Byenio/formula-student-radio-system/software/statlink/figures/cpu_master.png

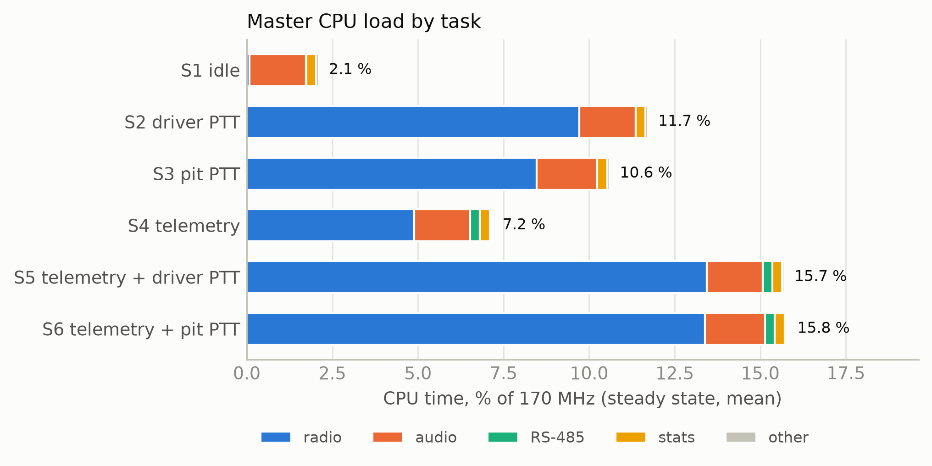
software/statlink/figures/cpu_master.png
