Byenio/formula-student-radio-system/software/statlink/figures/delivery.png

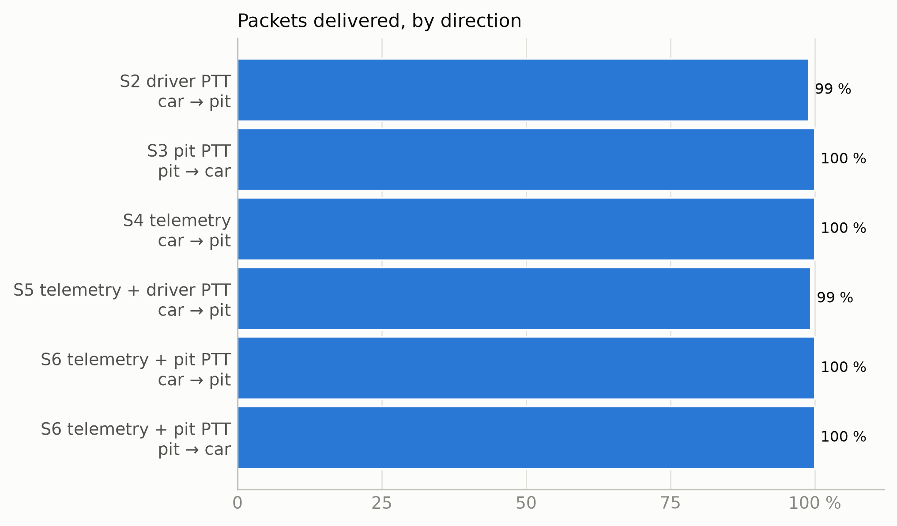
software/statlink/figures/delivery.png
