Byenio/formula-student-radio-system/software/statlink/figures/s6_timeline.png

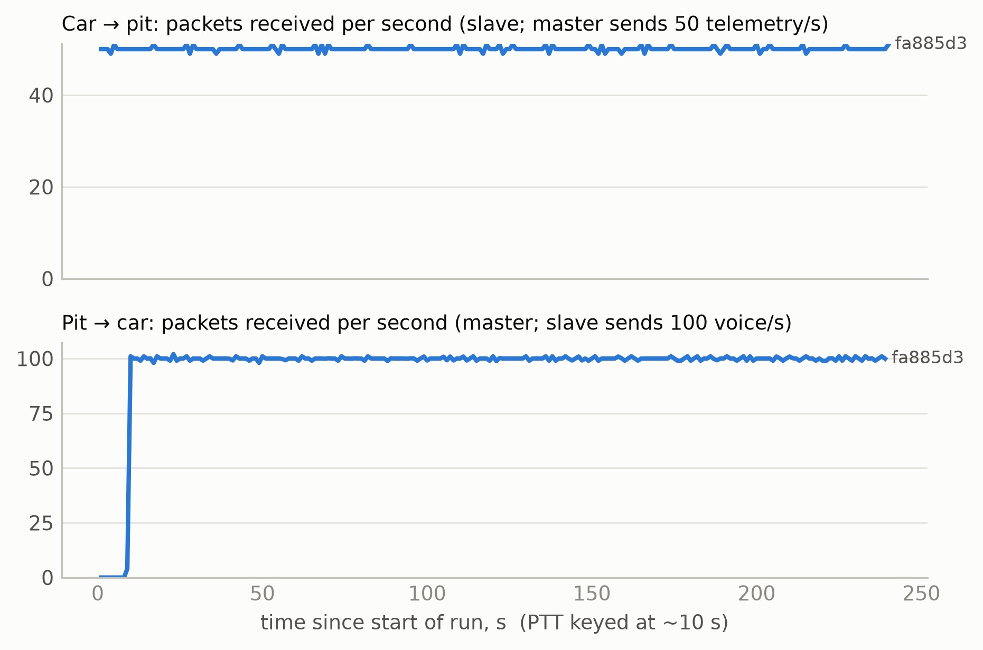
software/statlink/figures/s6_timeline.png
