Byenio/formula-student-radio-system/(list of files, drawings)

Other design files:
Radio_v2.PrjPcb
