Byenio/formula-student-radio-system/firmware/master/Core/Src/main.c

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
/* Includes ------------------------------------------------------------------*/
#include "main.h"
#include "cmsis_os.h"

/* USER CODE BEGIN Includes */
#include "audio.h"
#include "e28.h"
#include "ptt.h"
#include "rs485.h"
#include "can_bus.h"
#include "safety.h"
#include "stats.h"
/* USER CODE END Includes */

ADC_HandleTypeDef hadc1;
DMA_HandleTypeDef hdma_adc1;

DAC_HandleTypeDef hdac1;
DMA_HandleTypeDef hdma_dac1_ch1;

FDCAN_HandleTypeDef hfdcan1;

SPI_HandleTypeDef hspi2;

TIM_HandleTypeDef htim6;

UART_HandleTypeDef huart1;
DMA_HandleTypeDef hdma_usart1_rx;

/* Definitions for defaultTask */
osThreadId_t defaultTaskHandle;
const osThreadAttr_t defaultTask_attributes = {
  .name = "defaultTask",
  .priority = (osPriority_t) osPriorityNormal,
  .stack_size = 512 * 4
};
/* Definitions for myTask02 */
osThreadId_t myTask02Handle;
const osThreadAttr_t myTask02_attributes = {
  .name = "myTask02",
  .priority = (osPriority_t) osPriorityLow,
  .stack_size = 512 * 4
};
/* USER CODE BEGIN PV */
volatile uint32_t reset_csr      = 0;
volatile uint8_t  rst_pin        = 0;   /* NRST pin pulled low       */
volatile uint8_t  rst_brownout   = 0;   /* supply dipped below BOR   */
volatile uint8_t  rst_software   = 0;   /* NVIC_SystemReset() called */
volatile uint8_t  rst_iwdg       = 0;   /* independent watchdog      */
volatile uint8_t  rst_wwdg       = 0;   /* window watchdog           */
volatile uint8_t  rst_lowpower   = 0;   /* illegal low-power entry   */
/* USER CODE END PV */

void SystemClock_Config(void);
static void MX_GPIO_Init(void);
static void MX_DMA_Init(void);
static void MX_ADC1_Init(void);
static void MX_DAC1_Init(void);
static void MX_TIM6_Init(void);
static void MX_SPI2_Init(void);
static void MX_USART1_UART_Init(void);
static void MX_FDCAN1_Init(void);
void StartDefaultTask(void *argument);
void StartTask02(void *argument);

/**
  * @brief  The application entry point.
  * @retval int
  */
int main(void)
{

  /* USER CODE BEGIN 1 */
	/* Latch why we last reset, before anything clears the flags. */
	  reset_csr    = RCC->CSR;
	  rst_pin      = (reset_csr & RCC_CSR_PINRSTF)  ? 1U : 0U;
	  rst_brownout = (reset_csr & RCC_CSR_BORRSTF)  ? 1U : 0U;
	  rst_software = (reset_csr & RCC_CSR_SFTRSTF)  ? 1U : 0U;
	  rst_iwdg     = (reset_csr & RCC_CSR_IWDGRSTF) ? 1U : 0U;
	  rst_wwdg     = (reset_csr & RCC_CSR_WWDGRSTF) ? 1U : 0U;
	  rst_lowpower = (reset_csr & RCC_CSR_LPWRRSTF) ? 1U : 0U;
	  __HAL_RCC_CLEAR_RESET_FLAGS();
  /* USER CODE END 1 */

  /* MCU Configuration--------------------------------------------------------*/

  /* Reset of all peripherals, Initializes the Flash interface and the Systick. */
  HAL_Init();

  /* Configure the system clock */
  SystemClock_Config();

  /* Initialize all configured peripherals */
  MX_GPIO_Init();
  MX_DMA_Init();
  MX_ADC1_Init();
  MX_DAC1_Init();
  MX_TIM6_Init();
  MX_SPI2_Init();
  MX_USART1_UART_Init();
  MX_FDCAN1_Init();
  /* USER CODE BEGIN 2 */
  /* Audio peripherals are armed by the audio task itself, so the DMA
     streams start only once the scheduler is running. */
  /* USER CODE END 2 */

  /* Init scheduler */
  osKernelInitialize();

  /* USER CODE BEGIN RTOS_MUTEX */
  /* add mutexes, ... */
  /* USER CODE END RTOS_MUTEX */

  /* USER CODE BEGIN RTOS_SEMAPHORES */
  /* add semaphores, ... */
  /* USER CODE END RTOS_SEMAPHORES */

  /* USER CODE BEGIN RTOS_TIMERS */
  /* start timers, add new ones, ... */
  /* USER CODE END RTOS_TIMERS */

  /* USER CODE BEGIN RTOS_QUEUES */
  /* add queues, ... */
  /* USER CODE END RTOS_QUEUES */

  /* Create the thread(s) */
  /* creation of defaultTask */
  defaultTaskHandle = osThreadNew(StartDefaultTask, NULL, &defaultTask_attributes);

  /* creation of myTask02 */
  myTask02Handle = osThreadNew(StartTask02, NULL, &myTask02_attributes);

  /* USER CODE BEGIN RTOS_THREADS */
  /* First: starts the cycle counter every other module's timing relies on,
     and sends the boot-time schema before anything else can fail. */
  Stats_Init();
  Audio_Init();
  E28_Init();
  RS485_Init();
  CanBus_Init();
  /* USER CODE END RTOS_THREADS */

  /* USER CODE BEGIN RTOS_EVENTS */
  /* add events, ... */
  /* USER CODE END RTOS_EVENTS */

  /* Start scheduler */
  osKernelStart();

  /* We should never get here as control is now taken by the scheduler */

  /* Infinite loop */
  /* USER CODE BEGIN WHILE */
  while (1)
  {
    /* USER CODE END WHILE */

    /* USER CODE BEGIN 3 */
    /* Unreachable: osKernelStart() above never returns.
       All application logic now lives in the task functions. */
  }
  /* USER CODE END 3 */
}

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
/* USER CODE BEGIN Header_StartDefaultTask */
/**
  * @brief  Function implementing the defaultTask thread.
  * @param  argument: Not used
  * @retval None
  */
/* USER CODE END Header_StartDefaultTask */
void StartDefaultTask(void *argument)
{
  /* USER CODE BEGIN 5 */
	for(;;)
	  {
	    CanBus_Poll();
	    Ptt_SetCanAuthority(CanBus_IsLinkAlive());

	    /* LED1: solid = VCU is talking to us over CAN, off = bench mode and the
	       board button is in charge. More informative than a heartbeat, and it
	       makes a dead harness obvious at a glance. */
	    HAL_GPIO_WritePin(STATUS_LED1_GPIO_Port, STATUS_LED1_Pin,
	                      CanBus_IsLinkAlive() ? GPIO_PIN_SET : GPIO_PIN_RESET);
	    osDelay(20);
	  }
  /* USER CODE END 5 */
}

/* USER CODE BEGIN Header_StartTask02 */
/**
* @brief Function implementing the myTask02 thread.
* @param argument: Not used
* @retval None
*/
/* USER CODE END Header_StartTask02 */
void StartTask02(void *argument)
{
  /* USER CODE BEGIN StartTask02 */
	Ptt_Init();

	  for(;;)
	  {
	    Ptt_Poll();

	    /* LED2 now shows mic state rather than button state -- during the
	       hangover the radio is still transmitting, but the driver has already
	       let go, and the light should agree with the driver. */
	    HAL_GPIO_WritePin(STATUS_LED2_GPIO_Port, STATUS_LED2_Pin,
	                      Ptt_IsOpen() ? GPIO_PIN_SET : GPIO_PIN_RESET);
	    osDelay(20);
	  }
  /* USER CODE END StartTask02 */
}

/**
  * @brief  Period elapsed callback in non blocking mode
  * @note   This function is called  when TIM7 interrupt took place, inside
  * HAL_TIM_IRQHandler(). It makes a direct call to HAL_IncTick() to increment
  * a global variable "uwTick" used as application time base.
  * @param  htim : TIM handle
  * @retval None
  */
void HAL_TIM_PeriodElapsedCallback(TIM_HandleTypeDef *htim)
{
  if (htim->Instance == TIM7)
  {
    HAL_IncTick();
  }
}

/**
  * @brief  This function is executed in case of error occurrence.
  * @retval None
  */
void Error_Handler(void)
{
  /* USER CODE BEGIN Error_Handler_Debug */
  /* Called by CubeMX init code when a HAL call fails. Used to spin silently;
     now it shuts the radio down and latches the call site -- the return
     address of this function -- so addr2line can say which init failed. */
  Safety_ErrorHandler(__builtin_return_address(0));
  /* USER CODE END Error_Handler_Debug */
}
#ifdef USE_FULL_ASSERT
/**
  * @brief  Reports the name of the source file and the source line number
  *         where the assert_param error has occurred.
  * @param  file: pointer to the source file name
  * @param  line: assert_param error line source number
  * @retval None
  */
void assert_failed(uint8_t *file, uint32_t line)
{
  /* USER CODE BEGIN 6 */
  /* User can add his own implementation to report the file name and line number,
     ex: printf("Wrong parameters value: file %s on line %d\r\n", file, line) */
  /* USER CODE END 6 */
}
#endif /* USE_FULL_ASSERT */
