Byenio/formula-student-radio-system/firmware/master/master.ioc

Mcu.UserName=STM32G491CETx
PA10.Signal=USART1_RX
PA11.Signal=FDCAN1_RX
PA12.Signal=FDCAN1_TX
PA13.Signal=SYS_JTMS-SWDIO
PA14.Signal=SYS_JTCK-SWCLK
PA4.Signal=COMP_DAC11_group
PA5.GPIO_Label=E28_BUSY
PA5.Signal=GPIO_Input
PA6.GPIO_Label=CAN_STB
PA6.Signal=GPIO_Output
PA7.GPIO_Label=CAN_SHDN
PA7.Signal=GPIO_Output
PA8.GPIO_Label=STATUS_LED1
PA8.Signal=GPIO_Output
PA9.Signal=USART1_TX
PB0.Signal=ADC1_IN15
PB10.GPIO_Label=E28_RX_EN
PB10.Signal=GPIO_Output
PB11.GPIO_Label=E28_NRESET
PB11.Signal=GPIO_Output
PB12.GPIO_Label=E28_CS
PB12.Signal=GPIO_Output
PB13.Signal=SPI2_SCK
PB14.Signal=SPI2_MISO
PB15.Signal=SPI2_MOSI
PB4.GPIO_Label=E28_DIO3
PB4.Signal=GPIO_Input
PB5.GPIO_Label=E28_DIO1
PB5.Signal=GPXTI5
PB6.GPIO_Label=E28_DIO2
PB6.Signal=GPIO_Input
PB7.GPIO_Label=STATUS_LED2
PB7.Signal=GPIO_Output
PB9.GPIO_Label=E28_TX_EN
PB9.Signal=GPIO_Output
PC13.GPIO_Label=PTT_BTN
PC13.Signal=GPIO_Input
PC14-OSC32_IN.GPIO_Label=RS485_RE_DE
PC14-OSC32_IN.Signal=GPIO_Output
PF0-OSC_IN.Signal=RCC_OSC_IN
PF1-OSC_OUT.Signal=RCC_OSC_OUT
