Byenio/formula-student-radio-system/firmware/slave/Core/Src/main.c

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
/* Includes ------------------------------------------------------------------*/
#include "main.h"
#include "app_usbx_device.h"

/* USER CODE BEGIN Includes */
#include "e28_radio.h"
#include "usb_link.h"
#include "safety.h"
#include "stats.h"
#include "perf.h"
/* USER CODE END Includes */

ADC_HandleTypeDef hadc1;

I2C_HandleTypeDef hi2c1;

SPI_HandleTypeDef hspi1;

UART_HandleTypeDef huart1;

PCD_HandleTypeDef hpcd_USB_DRD_FS;

void SystemClock_Config(void);
static void MX_GPIO_Init(void);
static void MX_I2C1_Init(void);
static void MX_SPI1_Init(void);
static void MX_USART1_UART_Init(void);
static void MX_USB_PCD_Init(void);
static void MX_ADC1_Init(void);
static void MX_ICACHE_Init(void);
/**
  * @brief  The application entry point.
  * @retval int
  */
int main(void)
{

  /* MCU Configuration--------------------------------------------------------*/

  /* Reset of all peripherals, Initializes the Flash interface and the Systick. */
  HAL_Init();

  /* Configure the system clock */
  SystemClock_Config();

  /* Initialize all configured peripherals */
  MX_GPIO_Init();
  MX_I2C1_Init();
  MX_SPI1_Init();
  MX_USART1_UART_Init();
  MX_USB_PCD_Init();
  MX_ADC1_Init();
  MX_ICACHE_Init();
  MX_USBX_Device_Init();
  /* USER CODE BEGIN 2 */
  if (ux_dcd_stm32_initialize((ULONG)USB_DRD_FS,
                                (ULONG)&hpcd_USB_DRD_FS) != UX_SUCCESS)
	{
	  Error_Handler();
	}

	if (HAL_PCD_Start(&hpcd_USB_DRD_FS) != HAL_OK)
	{
	  Error_Handler();
	}

  UsbLink_Init();
  E28_Init();

  if (E28_GetTestResult() == E28_TEST_OK)
  {
    (void)E28_Radio_RelayInit();
  }

  /* Last, so the boot-time schema reflects a fully initialised board. */
  Stats_Init();
  /* USER CODE END 2 */

  /* Infinite loop */
  /* USER CODE BEGIN WHILE */
  while (1)
  {
    /* USER CODE END WHILE */

    /* USER CODE BEGIN 3 */
    /* Each stage timed separately, and the whole pass as "loop": on a
       bare-metal board the loop rate is the CPU budget, and these four
       sections show where it goes. Stats_Poll sits outside the loop timing
       so the report it sends is not counted inside the pass it measures. */
    {
      PERF_BEGIN(PERF_LOOP);
      {
        PERF_BEGIN(PERF_USBX);
        ux_system_tasks_run();
        PERF_END(PERF_USBX);
      }
      {
        PERF_BEGIN(PERF_USBLINK);
        UsbLink_Poll();
        PERF_END(PERF_USBLINK);
      }
      {
        PERF_BEGIN(PERF_RELAY);
        E28_Radio_RelayPoll();
        PERF_END(PERF_RELAY);
      }
      PERF_END(PERF_LOOP);
    }

    Stats_Poll();
  }
  /* USER CODE END 3 */
}

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
/**
  * @brief  Period elapsed callback in non blocking mode
  * @note   This function is called  when TIM6 interrupt took place, inside
  * HAL_TIM_IRQHandler(). It makes a direct call to HAL_IncTick() to increment
  * a global variable "uwTick" used as application time base.
  * @param  htim : TIM handle
  * @retval None
  */
void HAL_TIM_PeriodElapsedCallback(TIM_HandleTypeDef *htim)
{
  if (htim->Instance == TIM6)
  {
    HAL_IncTick();
  }
}

/**
  * @brief  This function is executed in case of error occurrence.
  * @retval None
  */
void Error_Handler(void)
{
  /* USER CODE BEGIN Error_Handler_Debug */
  /* Called by CubeMX init code when a HAL call fails. Used to spin silently;
     now it shuts the radio down and latches the call site -- the return
     address of this function -- so addr2line can say which init failed. */
  Safety_ErrorHandler(__builtin_return_address(0));
  /* USER CODE END Error_Handler_Debug */
}
#ifdef USE_FULL_ASSERT
/**
  * @brief  Reports the name of the source file and the source line number
  *         where the assert_param error has occurred.
  * @param  file: pointer to the source file name
  * @param  line: assert_param error line source number
  * @retval None
  */
void assert_failed(uint8_t *file, uint32_t line)
{
  /* USER CODE BEGIN 6 */
  /* User can add his own implementation to report the file name and line number,
     ex: printf("Wrong parameters value: file %s on line %d\r\n", file, line) */
  /* USER CODE END 6 */
}
#endif /* USE_FULL_ASSERT */
