Byenio/formula-student-radio-system/firmware/master/Core/Inc/main.h

#define PTT_BTN_Pin GPIO_PIN_13
#define PTT_BTN_GPIO_Port GPIOC
#define RS485_RE_DE_Pin GPIO_PIN_14
#define RS485_RE_DE_GPIO_Port GPIOC
#define E28_BUSY_Pin GPIO_PIN_5
#define E28_BUSY_GPIO_Port GPIOA
#define CAN_STB_Pin GPIO_PIN_6
#define CAN_STB_GPIO_Port GPIOA
#define CAN_SHDN_Pin GPIO_PIN_7
#define CAN_SHDN_GPIO_Port GPIOA
#define E28_RX_EN_Pin GPIO_PIN_10
#define E28_RX_EN_GPIO_Port GPIOB
#define E28_NRESET_Pin GPIO_PIN_11
#define E28_NRESET_GPIO_Port GPIOB
#define E28_CS_Pin GPIO_PIN_12
#define E28_CS_GPIO_Port GPIOB
#define STATUS_LED1_Pin GPIO_PIN_8
#define STATUS_LED1_GPIO_Port GPIOA
#define E28_DIO3_Pin GPIO_PIN_4
#define E28_DIO3_GPIO_Port GPIOB
#define E28_DIO1_Pin GPIO_PIN_5
#define E28_DIO1_GPIO_Port GPIOB
#define E28_DIO1_EXTI_IRQn EXTI9_5_IRQn
#define E28_DIO2_Pin GPIO_PIN_6
#define E28_DIO2_GPIO_Port GPIOB
#define STATUS_LED2_Pin GPIO_PIN_7
#define STATUS_LED2_GPIO_Port GPIOB
#define E28_TX_EN_Pin GPIO_PIN_9
#define E28_TX_EN_GPIO_Port GPIOB
#define STATUS_LED1_BLINK_PERIOD_MS 500U
#define E28_SPI_HANDLE hspi2
#define E28_ROLE_TRANSMITTER 1
#define AUDIO_PATH 0
#define RS485_BENCH_TEST 1
