Byenio/formula-student-radio-system/firmware/slave/Core/Src/stats.c

/**
  ******************************************************************************
  * @file    stats.c
  * @brief   Statistics layer. See stats.h for the frame formats.
  *
  * IDENTICAL ON BOTH BOARDS.
  *
  * Scheduling
  * ----------
  * Master: a dedicated task at osPriorityLow, woken every STATS_SAMPLE_MS by
  * vTaskDelayUntil. Low, so it never delays audio, radio, RS-485 or CAN; the
  * cost of that is that under heavy load a report can be late, which shows up
  * as jitter in t_ms rather than as corrupted data.
  *
  * Slave: Stats_Poll() from the bare-metal main loop, checking HAL_GetTick.
  *
  * Either way the work per report is the same and is timed by the stats.self
  * section, so the layer's own cost is part of every log.
  ******************************************************************************
  */

#include "stats.h"

#if FW_STATS_ENABLE

#include <string.h>
#include "statlink.h"

/* ==========================================================================
   Board configuration
   ========================================================================== */

#if defined(FW_HOST_TEST)
  #define STATS_BOARD_ID    255U
  #define STATS_HAS_RTOS    0
  extern uint32_t stats_host_ms;
  extern uint32_t stats_host_core_hz;
  #define STATS_NOW_MS()    (stats_host_ms)
  #define STATS_CORE_HZ()   (stats_host_core_hz)
#else
  #include "main.h"
  #define STATS_NOW_MS()    HAL_GetTick()
  #define STATS_CORE_HZ()   SystemCoreClock
  #if defined(STM32G491xx)
    #define STATS_BOARD_ID  0U
    #define STATS_HAS_RTOS  1
  #elif defined(STM32U375xx)
    #define STATS_BOARD_ID  1U
    #define STATS_HAS_RTOS  0
  #else
    #error "stats.c: unknown board -- add it to the board configuration block"
  #endif
#endif

#if STATS_HAS_RTOS
  #include "cmsis_os2.h"
  #include "FreeRTOS.h"
  #include "task.h"
#endif

/* Build identity, generated by cmake/build_info.cmake on every build. */
#if defined(FW_HOST_TEST)
  #define FW_BUILD_GIT      "host-test"
  #define FW_BUILD_TYPE     "host"
#else
  #include "build_info.h"
#endif

#define STATS_TASKS_EVERY   (STATS_TASKS_MS  / STATS_SAMPLE_MS)
#define STATS_SCHEMA_EVERY  (STATS_SCHEMA_MS / STATS_SAMPLE_MS)

/* Largest payload is the schema: ~20 B header, ~100 B build string, and up
   to 64 fields and 16 sections at ~20 B each. */
#define STATS_PAYLOAD_MAX   1600U

/* ==========================================================================
   State
   ========================================================================== */

static uint8_t       payload[STATS_PAYLOAD_MAX];
static uint32_t      frame_seq;
static uint16_t      schema_id;
static uint32_t      report_count;
static uint32_t      last_window_cycles;
static perf_window_t perf_snap[PERF_COUNT];
static uint32_t      field_values[STATS_MAX_FIELDS];

#if STATS_HAS_RTOS
static TaskStatus_t  task_status[STATS_MAX_TASKS];
static UBaseType_t   prev_task_number[STATS_MAX_TASKS];
static uint32_t      prev_task_runtime[STATS_MAX_TASKS];
static uint32_t      prev_task_count;
static uint32_t      prev_total_runtime;
#else
static uint32_t      next_report_ms;
#endif

/* ==========================================================================
   Payload writer -- bounded; an overflow marks the frame bad, never corrupts
   ========================================================================== */

typedef struct
{
  uint16_t len;
  bool     overflow;
} writer_t;

static void put_bytes(writer_t *w, const void *src, uint32_t n)
{
  if (w->overflow || ((uint32_t)w->len + n > STATS_PAYLOAD_MAX))
  {
    w->overflow = true;
    return;
  }
  memcpy(&payload[w->len], src, n);
  w->len = (uint16_t)(w->len + n);
}

static void put_u8 (writer_t *w, uint8_t v)  { put_bytes(w, &v, 1U); }

static void put_u16(writer_t *w, uint16_t v)
{
  const uint8_t b[2] = { (uint8_t)v, (uint8_t)(v >> 8) };
  put_bytes(w, b, 2U);
}

static void put_u32(writer_t *w, uint32_t v)
{
  const uint8_t b[4] = { (uint8_t)v, (uint8_t)(v >> 8),
                         (uint8_t)(v >> 16), (uint8_t)(v >> 24) };
  put_bytes(w, b, 4U);
}

static void put_str(writer_t *w, const char *s)
{
  size_t n = (s != NULL) ? strlen(s) : 0U;
  if (n > 255U) { n = 255U; }
  put_u8(w, (uint8_t)n);
  put_bytes(w, s, (uint32_t)n);
}

/** Every frame starts with seq and timestamp. */
static void begin_frame(writer_t *w)
{
  w->len      = 0U;
  w->overflow = false;
  put_u32(w, frame_seq);
  put_u32(w, STATS_NOW_MS());
}

static void send_frame(uint8_t type, const writer_t *w)
{
  /* The sequence number advances even when a frame is refused, so a gap on
     the PC side means "lost", whether in the ring or on the wire. */
  frame_seq++;

  if (!w->overflow)
  {
    (void)StatLink_Send(type, payload, w->len);
  }
}

/* ==========================================================================
   Schema
   ========================================================================== */

/** The parts of the schema that define the data layout. Also hashed. */
static void put_layout(writer_t *w)
{
  put_u16(w, stats_field_count);
  for (uint32_t i = 0U; i < stats_field_count; i++)
  {
    put_u8(w, stats_fields[i].kind);
    put_str(w, stats_fields[i].name);
  }

  put_u8(w, (uint8_t)PERF_COUNT);
  for (uint32_t i = 0U; i < (uint32_t)PERF_COUNT; i++)
  {
    put_str(w, Perf_Name((perf_id_t)i));
  }
}

static void compute_schema_id(void)
{
  writer_t w = { 0U, false };
  put_layout(&w);
  schema_id = StatLink_Crc16(0xFFFFU, payload, w.len);
}

static void send_schema(void)
{
  writer_t w;

  begin_frame(&w);
  put_u8 (&w, STATS_PROTO_VERSION);
  put_u8 (&w, STATS_BOARD_ID);
  put_u16(&w, schema_id);
  put_u32(&w, STATS_CORE_HZ());
  put_u16(&w, STATS_SAMPLE_MS);
  put_u16(&w, STATS_HAS_RTOS ? STATS_TASKS_MS : 0U);
  put_u32(&w, Perf_GetOverhead());
  put_u8 (&w, Perf_IsSupported() ? 1U : 0U);
  put_u32(&w, STATLINK_BAUD);
  /* __VERSION__ is the compiler's own version string: the master and slave
     can be built by different toolchains, and timing results are only
     comparable between builds from the same one. */
  put_str(&w, FW_BUILD_GIT " " FW_BUILD_TYPE " gcc " __VERSION__);
  put_layout(&w);

  send_frame(STATS_FRAME_SCHEMA, &w);
}

/* ==========================================================================
   Data frames
   ========================================================================== */

static void send_sample(void)
{
  writer_t w;
  const uint32_t n = (stats_field_count <= STATS_MAX_FIELDS) ? stats_field_count
                                                             : STATS_MAX_FIELDS;

  stats_fields_read(field_values);

  begin_frame(&w);
  put_u16(&w, schema_id);
  for (uint32_t i = 0U; i < n; i++)
  {
    put_u32(&w, field_values[i]);
  }

  send_frame(STATS_FRAME_SAMPLE, &w);
}

static void send_perf(void)
{
  writer_t w;
  const uint32_t now = Perf_Now();

  Perf_Snapshot(perf_snap);

  begin_frame(&w);
  put_u16(&w, schema_id);
  put_u32(&w, now - last_window_cycles);   /* how long this window was */
  last_window_cycles = now;

  for (uint32_t i = 0U; i < (uint32_t)PERF_COUNT; i++)
  {
    put_u32(&w, perf_snap[i].count);
    put_u32(&w, perf_snap[i].min);
    put_u32(&w, perf_snap[i].max);
    put_u32(&w, perf_snap[i].sum);
  }

  send_frame(STATS_FRAME_PERF, &w);
}

#if STATS_HAS_RTOS
/**
  * @brief  Per-task CPU time and stack, plus heap.
  *
  * The run-time clock is the DWT cycle counter (see FreeRTOSConfig.h). It
  * wraps every 2^32 cycles -- 25.3 s at 170 MHz -- so absolute per-task
  * totals are meaningless after that; only the differences between two
  * reports are used, and unsigned subtraction makes those correct across a
  * wrap as long as reports are less than 25 s apart. At each wrap FreeRTOS
  * itself discards one time slice (it guards against "negative" elapsed
  * time), so the error is bounded by one slice per 25 s.
  */
static void send_tasks(void)
{
  writer_t w;
  uint32_t total = 0U;

  const UBaseType_t n = uxTaskGetSystemState(task_status, STATS_MAX_TASKS, &total);

  begin_frame(&w);
  put_u32(&w, total - prev_total_runtime);
  put_u32(&w, (uint32_t)xPortGetFreeHeapSize());
  put_u32(&w, (uint32_t)xPortGetMinimumEverFreeHeapSize());
  put_u8 (&w, (uint8_t)n);

  for (UBaseType_t i = 0U; i < n; i++)
  {
    const TaskStatus_t *t = &task_status[i];
    uint32_t prev = 0U;

    /* Match by task number, not array index: uxTaskGetSystemState does not
       promise a stable order. A task not seen before reports its whole
       counter, which is correct for a task that started this window. */
    for (uint32_t j = 0U; j < prev_task_count; j++)
    {
      if (prev_task_number[j] == t->xTaskNumber)
      {
        prev = prev_task_runtime[j];
        break;
      }
    }

    put_u8 (&w, (uint8_t)t->xTaskNumber);
    put_str(&w, t->pcTaskName);
    put_u8 (&w, (uint8_t)t->uxCurrentPriority);
    put_u8 (&w, (uint8_t)t->eCurrentState);
    put_u16(&w, (uint16_t)t->usStackHighWaterMark);
    put_u32(&w, t->ulRunTimeCounter - prev);
  }

  for (UBaseType_t i = 0U; i < n; i++)
  {
    prev_task_number[i]  = task_status[i].xTaskNumber;
    prev_task_runtime[i] = task_status[i].ulRunTimeCounter;
  }
  prev_task_count    = (uint32_t)n;
  prev_total_runtime = total;

  send_frame(STATS_FRAME_TASKS, &w);
}
#endif

/** One report. Identical on both boards; only the trigger differs. */
static void stats_report(void)
{
  PERF_BEGIN(PERF_STATS);

  report_count++;

  if ((report_count % STATS_SCHEMA_EVERY) == 0U)
  {
    send_schema();
  }

  send_sample();
  send_perf();

#if STATS_HAS_RTOS
  if ((report_count % STATS_TASKS_EVERY) == 0U)
  {
    send_tasks();
  }
#endif

  PERF_END(PERF_STATS);
}

/* ==========================================================================
   Public API
   ========================================================================== */

#if STATS_HAS_RTOS

static osThreadId_t stats_task_handle;

static const osThreadAttr_t stats_task_attributes =
{
  .name       = "stats",
  /* Below every functional task. A late report costs timestamp jitter; a
     stats task that preempted audio would cost the measurement itself. */
  .priority   = (osPriority_t)osPriorityLow,
  .stack_size = 256 * 4
};

static void Stats_Task(void *argument)
{
  (void)argument;

  TickType_t wake = xTaskGetTickCount();

  for (;;)
  {
    vTaskDelayUntil(&wake, pdMS_TO_TICKS(STATS_SAMPLE_MS));
    stats_report();
  }
}

void Stats_Poll(void) { }

#else

void Stats_Poll(void)
{
  const uint32_t now = STATS_NOW_MS();

  if ((int32_t)(now - next_report_ms) < 0)
  {
    return;
  }

  /* Fixed cadence, but no catch-up burst: after a long stall (a debugger
     halt, say) report once and resume, rather than firing every missed
     report back to back. */
  next_report_ms += STATS_SAMPLE_MS;
  if ((int32_t)(now - next_report_ms) >= 0)
  {
    next_report_ms = now + STATS_SAMPLE_MS;
  }

  stats_report();
}

#endif

void Stats_Init(void)
{
  Perf_Init();
  StatLink_Init();

  compute_schema_id();
  last_window_cycles = Perf_Now();
  send_schema();                      /* first one immediately, at boot */

#if STATS_HAS_RTOS
  stats_task_handle = osThreadNew(Stats_Task, NULL, &stats_task_attributes);
  if (stats_task_handle == NULL)
  {
    Error_Handler();
  }
#else
  next_report_ms = STATS_NOW_MS() + STATS_SAMPLE_MS;
#endif
}

#endif /* FW_STATS_ENABLE */
