Byenio/formula-student-radio-system/firmware/master/Core/Src/app_freertos.c

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

/* Includes ------------------------------------------------------------------*/
#include "FreeRTOS.h"
#include "task.h"
#include "main.h"

/* USER CODE BEGIN Includes */
#include "safety.h"
/* USER CODE END Includes */

/* Hook prototypes */
void vApplicationStackOverflowHook(xTaskHandle xTask, signed char *pcTaskName);
void vApplicationMallocFailedHook(void);

/* USER CODE BEGIN 4 */
void vApplicationStackOverflowHook(xTaskHandle xTask, signed char *pcTaskName)
{
  /* Called by the kernel when a task overruns its stack. configCHECK_FOR_
     STACK_OVERFLOW is 2, so the check is both a bounds test on the stack
     pointer and a pattern check on the far end of the stack.

     Returning from here resumes a task whose locals are already corrupt, so
     we do not: Safety_Fault latches the task name and stops the board. */
  (void)xTask;
  Safety_Fault(SAFETY_FAULT_STACK_OVERFLOW, (const char *)pcTaskName);
}
/* USER CODE END 4 */

/* USER CODE BEGIN 5 */
void vApplicationMallocFailedHook(void)
{
  /* pvPortMalloc returned NULL. Every allocation on this board happens during
     start-up -- tasks, queues and semaphores -- so in practice this means
     configTOTAL_HEAP_SIZE is too small for the current task stacks, which is
     exactly the failure mode to expect while sizing a codec's scratch needs.

     Named "heap" rather than a task name because the caller may be the kernel
     itself, before any task exists to name. */
  Safety_Fault(SAFETY_FAULT_MALLOC_FAILED, "heap");
}
/* USER CODE END 5 */
