Byenio/formula-student-radio-system/(commit log)

2025-11-08 inital commit
    [Radio_v2.PrjPcb]
2025-11-08 revert 9b198c039e77541f85af6ad24072cabb492cad53
    revert inital commit
    [Radio_v2.PrjPcb]
2026-03-18 fix(transceiver): fix transmission and encoding
    [app_freertos.c, main.c]
2026-04-12 fix: fix opus config
    [app_freertos.c, main.c]
2026-10-19 debug: switch rs485 to 115200 baudrate
2026-10-29 debug: switch radios to bench power
2026-10-30 fix(firmware): sender switching antenna path to idle during transmission
