Byenio/formula-student-radio-system/(notices)

Notices in the files:
firmware/slave/USBX/App/ux_device_descriptors.h:
Copyright (c) 2026 STMicroelectronics.
All rights reserved.
This software is licensed under terms that can be found in the LICENSE file
